Kemtop/LedCube512/(list of files, drawings)

Other design files:
Boards/cube_board.lay6
Boards/Grid.lay6
