Kemtop/LedCube512/Sources/CUBE_Gyver/russianFonts.h

//Русский текст. 
//У Алекса Гайвера кривая матрица русского текста. Поэтому тут только мои буквы, которые были нужны.
const uint8_t rusText[][8] = {
  //позиция в массиве это слой по вертикали
  {	0x81, 0xC3, 0xA5, 0x99, 0x81, 0x81, 0x81, 0x81}, //M
  {	0x18, 0x24, 0x42, 0x81, 0xFF, 0x81, 0x81, 0x81}, //A
  {	0x99, 0x99,	0x99, 0x99, 0x99, 0x99, 0x99, 0xFF}, //Ш
  { 0x18, 0x24, 0x42, 0x81, 0xFF, 0x81, 0x81, 0x81}, //A
};
